Juan27-hub/Microrraton27/Calibración_IRs.xlsx

ADC1 | Distance | ADC4 | Distance
5.8 | 20 | 30 | 20
6.2 | 19.5 | 32 | 19.5
7 | 19 | 34 | 19
7.6 | 18.5 | 37 | 18.5
8.1 | 18 | 40 | 18
8.8 | 17.5 | 43 | 17.5
9.3 | 17 | 46 | 17
10.6 | 16.5 | 50 | 16.5
11.6 | 16 | 54 | 16
12.8 | 15.5 | 58 | 15.5
14 | 15 | 63 | 15
15 | 14.5 | 68 | 14.5
18 | 14 | 74 | 14
19.7 | 13.5 | 80 | 13.5
22.9 | 13 | 87 | 13
23.9 | 12.5 | 94 | 12.5
27.6 | 12 | 103 | 12
30.14 | 11.5 | 113 | 11.5
33.8 | 11 | 124 | 11
39.89 | 10.5 | 135 | 10.5
43 | 10 | 147 | 10
50 | 9.5 | 162 | 9.5
58 | 9 | 180 | 9
70 | 8.5 | 201 | 8.5
82 | 8 | 224 | 8
94 | 7.5 | 250 | 7.5
111 | 7 | 282 | 7
128 | 6.5 | 322 | 6.5
156 | 6 | 363 | 6
189 | 5.5 | 422 | 5.5
230 | 5 | 481 | 5
298 | 4.5 | 555 | 4.5
370 | 4 | 637 | 4
494 | 3.5 | 743 | 3.5
633 | 3 | 850 | 3
783 | 2.5 | 970 | 2.5
980 | 2 | 1043 | 2
1230 | 1.5
1395 | 1
1356 | 0.5
