Juan27-hub/Microrraton27/Trayectorias_microrratón/Core/Src/main.c

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
/* Includes ------------------------------------------------------------------*/
#include "main.h"
#include "cmsis_os.h"
#include "usb_device.h"

/* USER CODE BEGIN Includes */
#include "ades_motordc.h"
#include "ades_odometria.h"
#include "ades_trapezoidal.h"
#include "ades_usb.h"
#include "ades_speedcontrol.h"
#include "ades_movimiento.h"
#include "ades_ir.h"
/* USER CODE END Includes */

ADC_HandleTypeDef hadc1;

TIM_HandleTypeDef htim1;
TIM_HandleTypeDef htim2;
TIM_HandleTypeDef htim3;
TIM_HandleTypeDef htim4;
TIM_HandleTypeDef htim5;
TIM_HandleTypeDef htim10;

osThreadId Task1Handle;
uint32_t Task1Buffer[ 128 ];
osStaticThreadDef_t Task1ControlBlock;
osThreadId Task2Handle;
uint32_t Task2Buffer[ 128 ];
osStaticThreadDef_t Task2ControlBlock;
osThreadId Task3Handle;
uint32_t Task3Buffer[ 128 ];
osStaticThreadDef_t Task3ControlBlock;
osThreadId Task4Handle;
uint32_t Task4Buffer[ 128 ];
osStaticThreadDef_t Task4ControlBlock;
/* USER CODE BEGIN PV */
Pose pose;
ControlSpeed pid;
Eye eye;
Move move;

volatile uint8_t data = 0;
volatile uint8_t exti = 0;
volatile uint8_t acelera = 0;
volatile uint8_t mantenga = 0;
volatile uint8_t desacelera = 0;
volatile uint32_t time_s = 0;

uint8_t flag1 = 0;
uint8_t flag2 = 0;
uint32_t counter1 = 0;
uint32_t ccr_bruto = 0;
/* USER CODE END PV */

void SystemClock_Config(void);
static void MX_GPIO_Init(void);
static void MX_TIM2_Init(void);
static void MX_TIM3_Init(void);
static void MX_TIM4_Init(void);
static void MX_TIM5_Init(void);
static void MX_TIM1_Init(void);
static void MX_TIM10_Init(void);
static void MX_ADC1_Init(void);
void StartDefaultTask(void const * argument);
void StartTask02(void const * argument);
void StartTask03(void const * argument);
void StartTask04(void const * argument);

/* USER CODE BEGIN PFP */
void ades_delay_us(uint32_t tiempo);
/* USER CODE END PFP */

/**
  * @brief  The application entry point.
  * @retval int
  */
int main(void)
{

  /* MCU Configuration--------------------------------------------------------*/

  /* Reset of all peripherals, Initializes the Flash interface and the Systick. */
  HAL_Init();

  /* Configure the system clock */
  SystemClock_Config();

  /* Initialize all configured peripherals */
  MX_GPIO_Init();
  MX_TIM2_Init();
  MX_TIM3_Init();
  MX_TIM4_Init();
  MX_TIM5_Init();
  MX_TIM1_Init();
  MX_TIM10_Init();
  MX_ADC1_Init();
  /* USER CODE BEGIN 2 */
  HAL_TIM_Base_Start_IT(&htim2);
  HAL_TIM_Base_Start(&htim5);
  HAL_TIM_PWM_Start(&htim3, TIM_CHANNEL_2);
  HAL_TIM_PWM_Start(&htim10, TIM_CHANNEL_1);
  HAL_TIM_Encoder_Start(&htim4, TIM_CHANNEL_ALL);
  HAL_TIM_Encoder_Start(&htim1, TIM_CHANNEL_ALL);
  ades_speedcontrol_configure(&pid, 1.0, 1.0, 1.0, 290.0);
   pose.left_last_pulses = 0;
   pose.right_last_pulses = 0;
   move.time_s = 0;
   ADC_Init_Custom(&hadc1);
   ades_ir_PowerDownAll();

  /* USER CODE END 2 */

  /* USER CODE BEGIN RTOS_MUTEX */
  /* add mutexes, ... */
  /* USER CODE END RTOS_MUTEX */

  /* USER CODE BEGIN RTOS_SEMAPHORES */
  /* add semaphores, ... */
  /* USER CODE END RTOS_SEMAPHORES */

  /* USER CODE BEGIN RTOS_TIMERS */
  /* start timers, add new ones, ... */
  /* USER CODE END RTOS_TIMERS */

  /* USER CODE BEGIN RTOS_QUEUES */
  /* add queues, ... */
  /* USER CODE END RTOS_QUEUES */

  /* Create the thread(s) */
  /* definition and creation of Task1 */
  osThreadStaticDef(Task1, StartDefaultTask, osPriorityHigh, 0, 128, Task1Buffer, &Task1ControlBlock);
  Task1Handle = osThreadCreate(osThread(Task1), NULL);

  /* definition and creation of Task2 */
  osThreadStaticDef(Task2, StartTask02, osPriorityNormal, 0, 128, Task2Buffer, &Task2ControlBlock);
  Task2Handle = osThreadCreate(osThread(Task2), NULL);

  /* definition and creation of Task3 */
  osThreadStaticDef(Task3, StartTask03, osPriorityHigh, 0, 128, Task3Buffer, &Task3ControlBlock);
  Task3Handle = osThreadCreate(osThread(Task3), NULL);

  /* definition and creation of Task4 */
  osThreadStaticDef(Task4, StartTask04, osPriorityNormal, 0, 128, Task4Buffer, &Task4ControlBlock);
  Task4Handle = osThreadCreate(osThread(Task4), NULL);

  /* USER CODE BEGIN RTOS_THREADS */
  /* add threads, ... */
  /* USER CODE END RTOS_THREADS */

  /* Start scheduler */
  osKernelStart();

  /* We should never get here as control is now taken by the scheduler */

  /* Infinite loop */
  /* USER CODE BEGIN WHILE */
  while (1)
  {

    /* USER CODE END WHILE */

    /* USER CODE BEGIN 3 */
  }
  /* USER CODE END 3 */
}

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
/* USER CODE BEGIN 4 */

void ades_delay_us(uint32_t tiempo){
	TIM5->CNT = 0;
	while(TIM5->CNT >= tiempo);
}

void HAL_GPIO_EXTI_Callback(uint16_t GPIO_Pin){
    if(GPIO_Pin == GPIO_PIN_10) // If The INT Source Is EXTI Line9 (A9 Pin)
    {
    	flag1 = 1;// Toggle The Output (LED) Pin
    }
}


/* USER CODE END 4 */

/* USER CODE BEGIN Header_StartDefaultTask */
/**
  * @brief  Function implementing the Task1 thread.
  * @param  argument: Not used
  * @retval None
  */
/* USER CODE END Header_StartDefaultTask */
void StartDefaultTask(void const * argument)
{
  /* init code for USB_DEVICE */
  MX_USB_DEVICE_Init();
  /* USER CODE BEGIN 5 */
  /* Infinite loop */
  for(;;)
  {
	  updatePose ((int16_t) TIM4->CNT, (int16_t) TIM1->CNT, 10.0, &pose);
	  osDelay(10);
  }
  /* USER CODE END 5 */
}

/* USER CODE BEGIN Header_StartTask02 */
/**
* @brief Function implementing the Task2 thread.
* @param argument: Not used
* @retval None
*/
/* USER CODE END Header_StartTask02 */
void StartTask02(void const * argument)
{
  /* USER CODE BEGIN StartTask02 */
  /* Infinite loop */
  for(;;)
  {
	if(flag1 == 1){
		ades_movimiento_lineal(5*180.0, 100.0, 150.0, &pose, &move, &pid);
		ades_movimiento_angular(M_PI, 1.0, 4.8, &pose, &move, &pid);
		ades_movimiento_lineal(2*180.0, 100.0, 150.0, &pose, &move, &pid);
		flag1 = 0;
	}
    osDelay(1);
  }
  /* USER CODE END StartTask02 */
}

/* USER CODE BEGIN Header_StartTask03 */
/**
* @brief Function implementing the Task3 thread.
* @param argument: Not used
* @retval None
*/
/* USER CODE END Header_StartTask03 */
void StartTask03(void const * argument)
{
  /* USER CODE BEGIN StartTask03 */
  /* Infinite loop */
  for(;;){
	  ades_ir_CalculateDistances(&eye, &hadc1);
      osDelay(1);
  }
  /* USER CODE END StartTask03 */
}

/* USER CODE BEGIN Header_StartTask04 */
/**
* @brief Function implementing the Task4 thread.
* @param argument: Not used
* @retval None
*/
/* USER CODE END Header_StartTask04 */
void StartTask04(void const * argument)
{
  /* USER CODE BEGIN StartTask04 */
  /* Infinite loop */
  for(;;)
  {
    osDelay(1);
  }
  /* USER CODE END StartTask04 */
}

/**
  * @brief  This function is executed in case of error occurrence.
  * @retval None
  */
void Error_Handler(void)
{
  /* USER CODE BEGIN Error_Handler_Debug */
  /* User can add his own implementation to report the HAL error return state */
  __disable_irq();
  while (1)
  {
  }
  /* USER CODE END Error_Handler_Debug */
}

#ifdef  USE_FULL_ASSERT
/**
  * @brief  Reports the name of the source file and the source line number
  *         where the assert_param error has occurred.
  * @param  file: pointer to the source file name
  * @param  line: assert_param error line source number
  * @retval None
  */
void assert_failed(uint8_t *file, uint32_t line)
{
  /* USER CODE BEGIN 6 */
  /* User can add his own implementation to report the file name and line number,
     ex: printf("Wrong parameters value: file %s on line %d\r\n", file, line) */
  /* USER CODE END 6 */
}
#endif /* USE_FULL_ASSERT */
