Juan27-hub/Microrraton27/Sistema_MedicionIR/Sistema_MedicionIR.ioc

Mcu.UserName=STM32F411CEUx
PA11.Signal=USB_OTG_FS_DM
PA12.Signal=USB_OTG_FS_DP
PA2.Signal=GPIO_Output
PA3.Signal=GPIO_Output
PA4.Signal=ADCx_IN4
PA5.Signal=ADCx_IN5
PA6.Signal=ADCx_IN6
PA7.Signal=ADCx_IN7
PB12.Signal=GPIO_Output
PB13.Signal=GPIO_Output
PB14.Signal=GPIO_Output
PB15.Signal=GPIO_Output
PC13-ANTI_TAMP.Signal=GPIO_Output
